I-M-Robotics-Lab/3D-printed-CNC---Lambda/Lambda v2 CNC Partlist.pdf

# CNC Material List

Category Type Object Supplier SKU Quantity Pack of Unit Price Subtotal
Hardware: | (price as of 11/24)
| Rails:
750XMGN15C | https://www.aliexpress.us/item/3256804609221227.html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 2 | 1 | $48.43 | $96.86
600XMGN15C | https://www.aliexpress.us/item/3256804609221227.html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 2 | 1 | $36.98 | $73.96
150XMGN15C | https://www.aliexpress.us/item/3256804609221227.html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 2 | 1 | $18.64 | $37.28

Aluminum:
700X4080 | https://www.amazon.com/dp/B0BXNKXXFZ?ref=ppx_yo2ov_dt_b_product_details&th=1 1 | 2 | $47.99 | $47.99
1000X4080 | https://www.amazon.com/dp/B0BXNG6J1D?ref=ppx_yo2ov_dt_b_product_details&th=1 1 | 2 | $63.99 | $63.99
1220X2020 | https://www.amazon.com/dp/B0BX6BHRLJ?ref=ppx_yo2ov_dt_b_product_details&th=1 1 | 10 | $63.99 | $63.99 basically aluminum extrusions that are about 600mm
20x100x150 | https://www.aliexpress.us/item/3256801418379178.html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 1 | 1 | $6.39 | $6.39
Ballscrew Nut Housing | https://www.aliexpress.us/item/3256803881213391.html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 1 | 4 | $13.04 | $13.04
Spindle Clamp | https://www.aliexpress.us/item/3256806122877123.html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 1 | 1 | $29.59 | $29.59

Ball screws
| 850XSFU1204 700XSFU1204 | https://www.aliexpress.us/item/3256802486685399.html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 2 1 $27.71 $55.42 https://www.aliexpress.us/item/3256802486685399.html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 1 1 $27.00 $27.00
200XSFU1204 | https://www.amazon.com/gp/product/B0BC7NF2CW/ref=ppx_yo_dt_b_asin_title_o02_s00?ie=UTF8&th=1 1 | 1 | $19.00 | $19.00

Fasteners
M8X40 | https://www.amazon.com/M8-1-25-Socket-Screws-Stainless-Machine/dp/B0BPXFL6RQ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 1 15(12 Needed) | $9.99 | $9.99
M5x80&M5x70 | https://www.amazon.com/iExcell-Stainless-Socket-Screws-Assortment/dp/B07Q1PC5CT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 1 25 (8 needed) | $8.28 | $8.28
M5x50 | https://www.amazon.com/Alloy-Steel-Socket-Screw-Black/dp/B015A366TK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 1 20 (8 needed) | $10.09 | $10.09
M5x25 | https://www.amazon.com/Socket-Screws-Metric-Machine-Threaded/dp/B0969RMH6Y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 1 50(10 needed) | $9.99 | $9.99
M4x14 | https://www.amazon.com/FullerKreg-M4-0-7-Alloy-Socket-Finish/dp/B07B2R7LZF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 1 100(24) needed | $9.12 | $9.12
M4TNuts | https://www.amazon.com/SpzcdZa-Sliding-Fastener-Aluminum-Extrusion/dp/B08145QK3B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 1 | 105 | $6.99 | $6.99
M3X25 | (16 needed)
M3X14 | (20 needed)
M3 Kit | https://www.amazon.com/VIGRUE-610PCS-Socket-Machine-Assortment/dp/B09NR8X2LV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 1 | 610 | $17.99 | $17.99
M3.5x14 | https://www.ebay.com/itm/184981022429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 2 50(ALOT) | | $10.74 | $21.48
M3.5 nuts | https://www.amazon.com/uxcell-Metric-Thread-Stainless-Fastener/dp/B0143GL8WA 1 | 100 | $9.89 | $9.89
4040 TNuts | https://www.amazon.com/Binzzo-Elastic-Aluminum-Extrusion-Profile/dp/B085B7L7WR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 1 | 25 | $9.89 | $9.89
Brass Inserts | https://www.amazon.com/Ktehloy-Threaded-Assortment-Printing-Components/dp/B0CLKDPN65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 1 | 1 | $15.09 | $15.09

3D Parts
FIlament - ABS | https://www.amazon.com/SUNLU-Printer-Filament-Dimensional-Accuracy/dp/B07XF5KM74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 2 | 1 | $16.00 | $32.00

Electronics
| Control System
IOT Switching Relay Power Strip https://openbuildspartstore.com/iot-switching-relay-power-strip/ 1 | 1 | $39.99 | $39.99
24V Meanwell Power Supply Bundlehttps://openbuildspartstore.com/24v-meanwell-power-supply-bundle/ 1 | 1 | $90.00 | $90.00
Xtension Limit Switch Kit | https://openbuildspartstore.com/xtension-limit-switch-kit/ 3 | 1 | $7.99 | $23.97
NEMA 23 Stepper Motor - High Torque Series https://openbuildspartstore.com/nema-23-stepper-motor-high-torque-series/ 3 | 1 | $42.00 | $126.00
NEMA 23 Stepper Motor | https://openbuildspartstore.com/nema-23-stepper-motor/ 1 | 1 | $28.00 | $28.00
BlackBox Motion Control System X32https://openbuildspartstore.com/BlackBox-Motion-Control-System-X32 1 | 1 | $239.99 | $239.99

Router
Router/spindle | https://www.amazon.com/Makita-RT0701C-1-1-Compact-Router/dp/B00E7D3V4S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 1 | 1 | $100.00 | $100.00

Total
$1,343.26
