I-M-Robotics-Lab/3D-printed-CNC---Lambda/Printed Parts/Z_Top.step

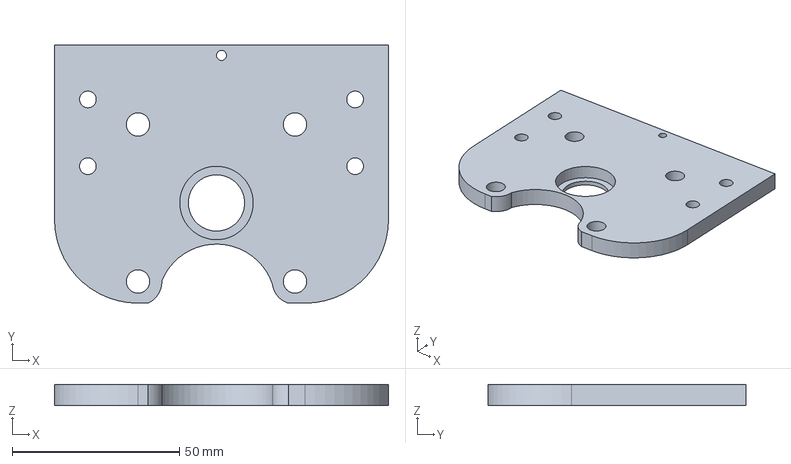
[picture p6: CAD file, 2025-01-05]
Printed Parts/Z_Top.step
100.0 x 77.3 x 6.35 mm
