I-M-Robotics-Lab/3D-printed-CNC---Lambda/Printed Parts/X_Frontleft.step

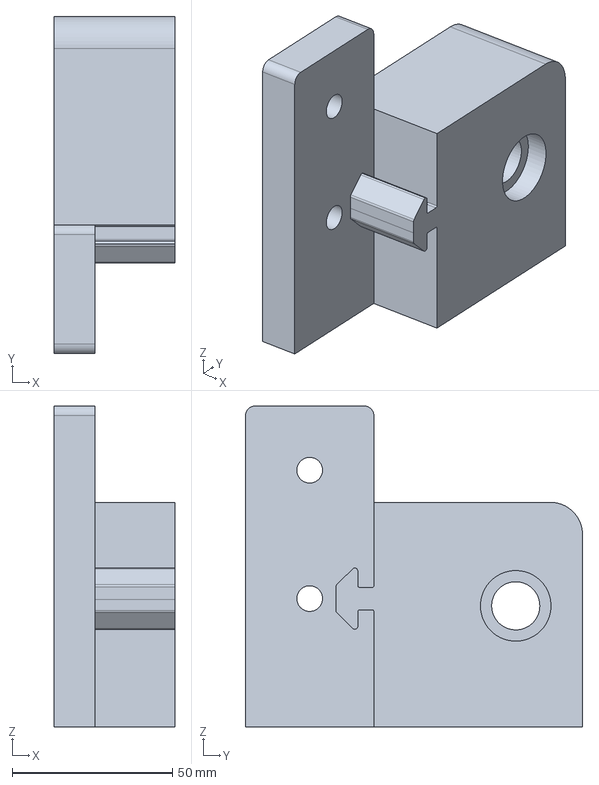
[picture p7: CAD file, 2025-01-05]
Printed Parts/X_Frontleft.step
37.7 x 105.0 x 100.0 mm
