I-M-Robotics-Lab/3D-printed-CNC---Lambda/Printed Parts/Z_Mountingblock.step

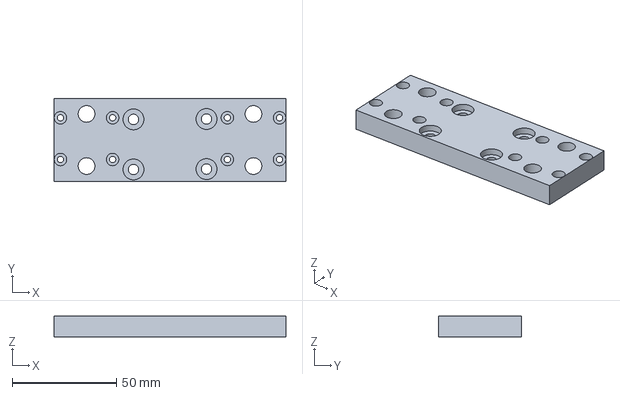
[picture p8: CAD file, 2025-01-05]
Printed Parts/Z_Mountingblock.step
111.2 x 40.0 x 10.0 mm
