I-M-Robotics-Lab/3D-printed-CNC---Lambda/Printed Parts/Y_LeftGantry.step

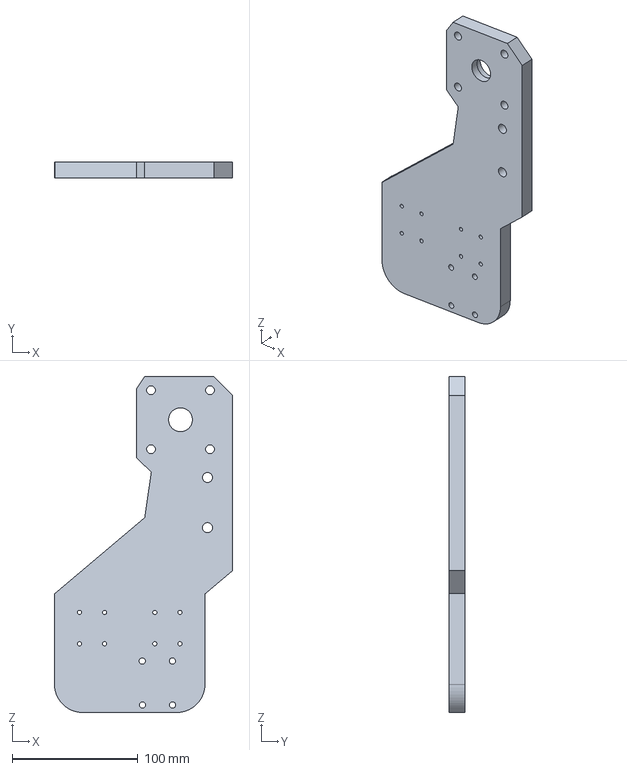
[picture p9: CAD file, 2025-01-05]
Printed Parts/Y_LeftGantry.step
142.0 x 12.7 x 267.7 mm
