I-M-Robotics-Lab/3D-printed-CNC---Lambda/Printed Parts/Z_Backplate.step

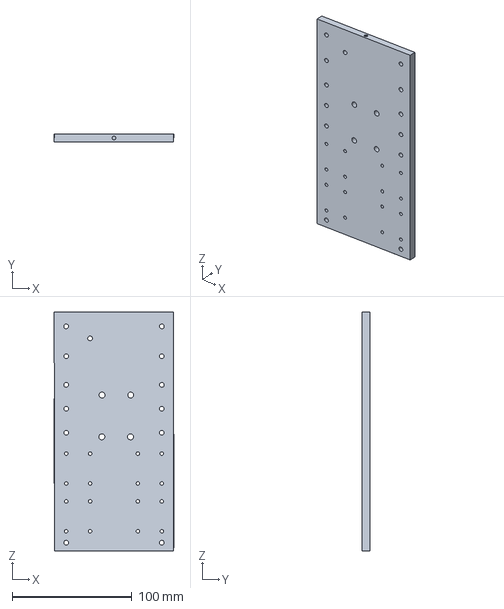
[picture p10: CAD file, 2025-01-05]
Printed Parts/Z_Backplate.step
100.0 x 6.35 x 200.0 mm
