I-M-Robotics-Lab/3D-printed-CNC---Lambda/Printed Parts/X_Backleft.step

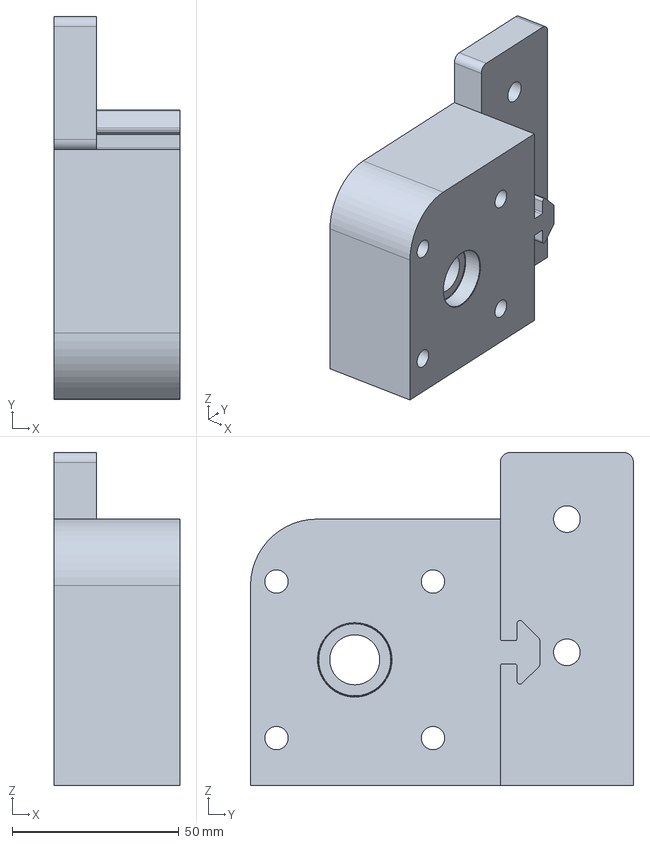
[picture p11: CAD file, 2025-01-05]
Printed Parts/X_Backleft.step
37.7 x 115.0 x 100.0 mm
