I-M-Robotics-Lab/3D-printed-CNC---Lambda/Printed Parts/Z_bottom.step

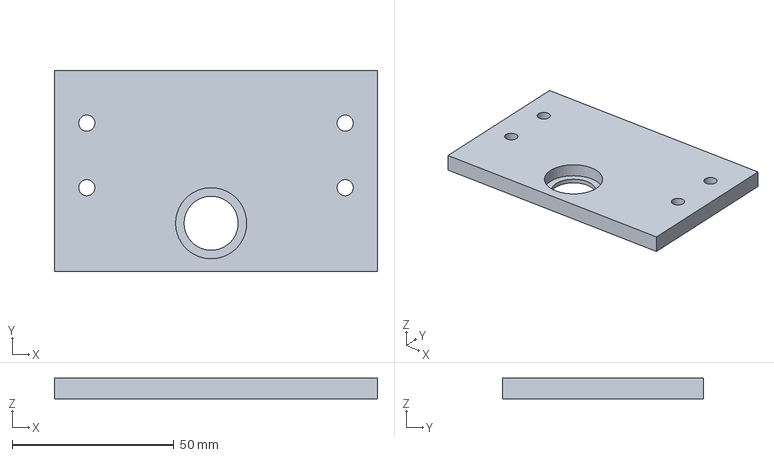
[picture p12: CAD file, 2025-01-05]
Printed Parts/Z_bottom.step
100.0 x 62.4 x 6.35 mm
