I-M-Robotics-Lab/3D-printed-CNC---Lambda/Printed Parts/Y_RightGantry.step

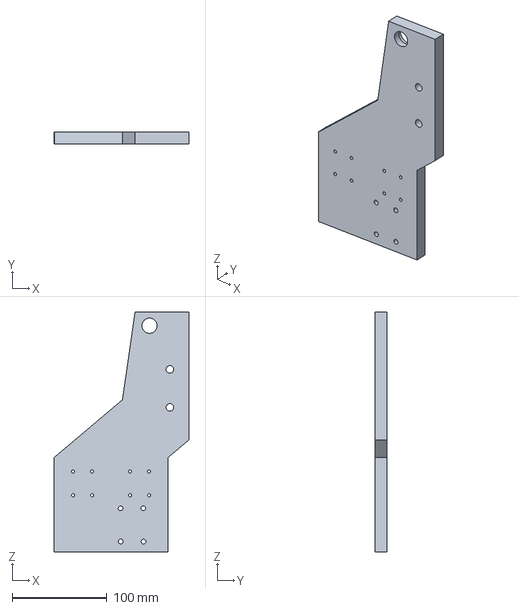
[picture p13: CAD file, 2025-01-05]
Printed Parts/Y_RightGantry.step
142.0 x 12.7 x 252.7 mm
