I-M-Robotics-Lab/3D-printed-CNC---Lambda/(list of files, cad)

Other CAD files:
Printed Parts/X_Frontright.step
Printed Parts/X_Backright.step
